hoangthuong266/Automatic-light-bulb/(list of files, drawings)

Other design files:
Do_an_1.pdsprj
